nerdmaennchen/motor_unicorn_3000_hw/motor_unicorn.kicad_pcb

## KiCad design motor_unicorn.kicad_pcb (2024-05-05)

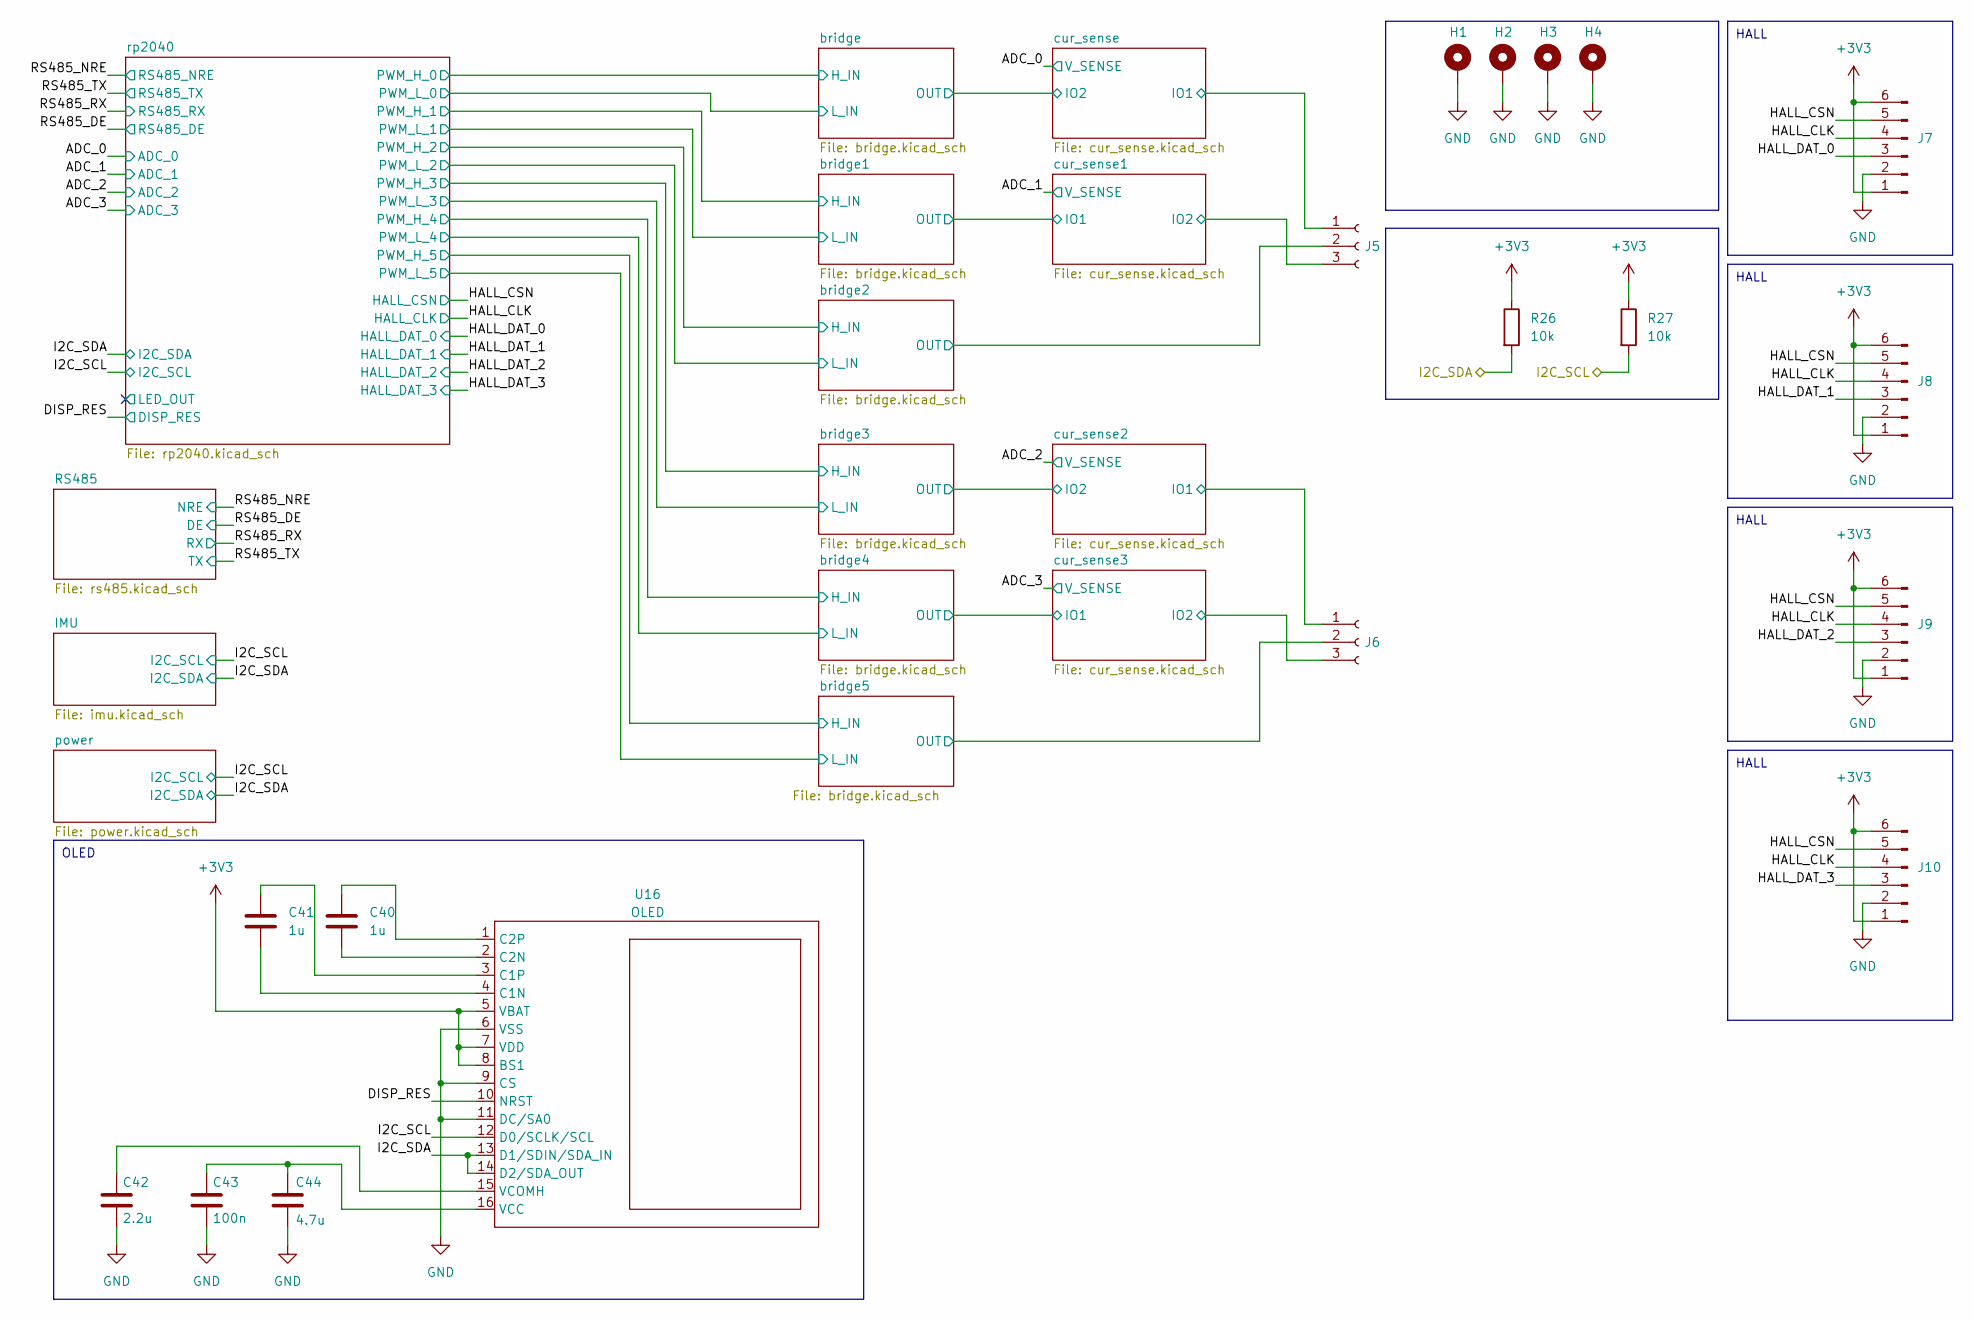
[picture p1: schematic motor_unicorn.kicad_sch]

Parts:
C40, C41: 1u; C_0402_1005Metric; LCSC C52923
C42: 2.2u; C_0805_2012Metric; LCSC C12530
C43: 100n; C_0402_1005Metric; LCSC C1525
C44: 4.7u; C_0603_1608Metric; LCSC C19666
H1, H2, H3, H4: MountingHole_Pad; MountingHole_3.2mm_M3_DIN965_Pad_TopBottom
J5, J6: Conn_01x03_Socket; TerminalBlock_Altech_AK300-3_P5.00mm; LCSC C8270
J7, J8, J9, J10: Conn_01x06_Pin; JST_PH_B6B-PH-K_1x06_P2.00mm_Vertical; LCSC C131342
R26, R27: 10k; R_0402_1005Metric
U16: OLED

Connections:
+3V3: J7.1, J7.6, J8.1, J8.6, J9.1, J9.6, J10.1, J10.6, R26.1, R27.1, U16.5 (VBAT), U16.7 (VDD), U16.8 (BS1); also elsewhere on the board
/DISP_RES: U16.10 (NRST); also elsewhere on the board
/HALL_CLK: J7.4, J8.4, J9.4, J10.4; also elsewhere on the board
/HALL_CSN: J7.5, J8.5, J9.5, J10.5; also elsewhere on the board
/HALL_DAT_0: J7.3; also elsewhere on the board
/HALL_DAT_1: J8.3; also elsewhere on the board
/HALL_DAT_2: J9.3; also elsewhere on the board
/HALL_DAT_3: J10.3; also elsewhere on the board
/I2C_SCL: R27.2, U16.12 (D0/SCLK/SCL); also elsewhere on the board
/I2C_SDA: R26.2, U16.13 (D1/SDIN/SDA_IN), U16.14 (D2/SDA_OUT); also elsewhere on the board
/bridge2/OUT: J5.2; also elsewhere on the board
/bridge5/OUT: J6.2; also elsewhere on the board
/cur_sense1/IO2: J5.3; also elsewhere on the board
/cur_sense2/IO1: J6.1; also elsewhere on the board
/cur_sense3/IO2: J6.3; also elsewhere on the board
/cur_sense/IO1: J5.1; also elsewhere on the board
GND: C42.2, C43.2, C44.2, H1.1, H2.1, H3.1, H4.1, J7.2, J8.2, J9.2, J10.2, U16.6 (VSS), U16.9 (CS), U16.11 (DC/SA0); also elsewhere on the board
unnamed: C41.2, U16.4 (C1N)
unnamed: C41.1, U16.3 (C1P)
unnamed: C40.2, U16.2 (C2N)
unnamed: C40.1, U16.1 (C2P)
unnamed: C43.1, C44.1, U16.16 (VCC)
unnamed: C42.1, U16.15 (VCOMH)

Notes on the sheet:
HALL
OLED

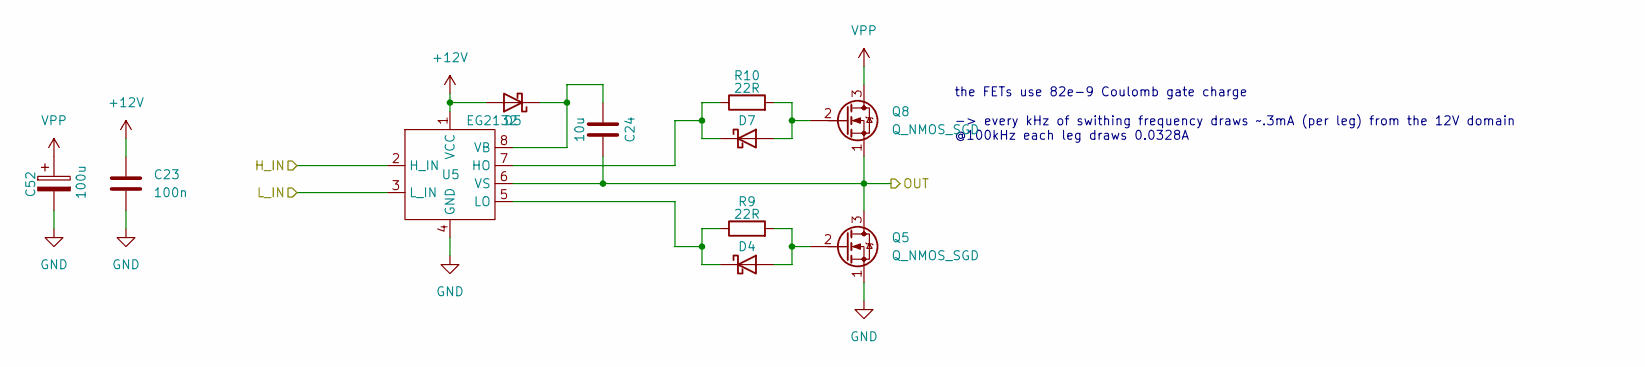
[picture p2: schematic bridge.kicad_sch]

Parts:
C23: 100n; C_0402_1005Metric
C24: 10u; C_0603_1608Metric
C52: 100u; CP_Elec_6.3x7.7
D4, D5, D7: D_Schottky; D_SOD-323
Q5, Q8: Q_NMOS_SGD; PQFN-8-EP_6x5mm_P1.27mm_Generic
R9, R10: 22R; R_0402_1005Metric
U5: EG2132; SSOP-8_3.9x5.05mm_P1.27mm

Connections:
+12V: C23.1, D5.2 (A), U5.1 (VCC); also elsewhere on the board
/bridge1/H_IN: U5.2 (H_IN); also elsewhere on the board
/bridge1/L_IN: U5.3 (L_IN); also elsewhere on the board
GND: C23.2, C52.2, Q5.1 (S), U5.4 (GND); also elsewhere on the board
unnamed: D7.1 (K), R10.1, U5.7 (HO)
VPP: C52.1, Q8.3 (D); also elsewhere on the board

Parts of its further copies:
C21, C26, C33, C35, C37: 10u; C_0603_1608Metric
C22, C25, C32, C34, C36: 100n; C_0402_1005Metric
C53, C54, C55, C56, C57: 100u; CP_Elec_6.3x7.7
D3, D6, D8, D9, D10, D11, D12, D13, D14, D15, D16, D17, D18, D19, D20: D_Schottky; D_SOD-323
Q2, Q3, Q4, Q6, Q7, Q9, Q10, Q11, Q12, Q13: Q_NMOS_SGD; PQFN-8-EP_6x5mm_P1.27mm_Generic
R8, R11, R12, R13, R18, R19, R20, R21, R22, R23: 22R; R_0402_1005Metric
U4, U6, U11, U12, U13: EG2132; SSOP-8_3.9x5.05mm_P1.27mm

Connections of its further copies:
+12V: C22.1, C25.1, C32.1, C34.1, C36.1, D6.2 (A), D9.2 (A), D12.2 (A), D15.2 (A), D18.2 (A), U4.1 (VCC), U6.1 (VCC), U11.1 (VCC), U12.1 (VCC), U13.1 (VCC); also elsewhere on the board
/bridge2/H_IN: U6.2 (H_IN); also elsewhere on the board
/bridge2/L_IN: U6.3 (L_IN); also elsewhere on the board
/bridge2/OUT: C26.1, Q4.3 (D), Q10.1 (S), U6.6 (VS); also elsewhere on the board
/bridge3/H_IN: U11.2 (H_IN); also elsewhere on the board
/bridge3/L_IN: U11.3 (L_IN); also elsewhere on the board
/bridge4/H_IN: U12.2 (H_IN); also elsewhere on the board
/bridge4/L_IN: U12.3 (L_IN); also elsewhere on the board
/bridge4/OUT: C35.1, Q6.3 (D), Q12.1 (S), U12.6 (VS); also elsewhere on the board
/bridge5/H_IN: U13.2 (H_IN); also elsewhere on the board
/bridge5/L_IN: U13.3 (L_IN); also elsewhere on the board
/bridge5/OUT: C37.1, Q7.3 (D), Q13.1 (S), U13.6 (VS); also elsewhere on the board
/bridge/H_IN: U4.2 (H_IN); also elsewhere on the board
/bridge/L_IN: U4.3 (L_IN); also elsewhere on the board
GND: C22.2, C25.2, C32.2, C34.2, C36.2, C53.2, C54.2, C55.2, C56.2, C57.2, Q2.1 (S), Q3.1 (S), Q4.1 (S), Q6.1 (S), Q7.1 (S), U4.4 (GND), U6.4 (GND), U11.4 (GND), U12.4 (GND), U13.4 (GND); also elsewhere on the board
unnamed: D3.1 (K), R8.1, U4.7 (HO)
unnamed: D8.2 (A), Q3.2 (G), R11.2
unnamed: C26.2, D9.1 (K), U6.8 (VB)
unnamed: D10.2 (A), Q10.2 (G), R12.2
unnamed: D10.1 (K), R12.1, U6.7 (HO)
unnamed: D11.2 (A), Q4.2 (G), R13.2
unnamed: D11.1 (K), R13.1, U6.5 (LO)
unnamed: C33.2, D12.1 (K), U11.8 (VB)
unnamed: D13.2 (A), Q11.2 (G), R18.2
unnamed: D13.1 (K), R18.1, U11.7 (HO)
unnamed: D14.1 (K), R19.1, U11.5 (LO)
unnamed: C35.2, D15.1 (K), U12.8 (VB)
unnamed: D16.2 (A), Q12.2 (G), R20.2
unnamed: D16.1 (K), R20.1, U12.7 (HO)
unnamed: D17.2 (A), Q6.2 (G), R21.2
unnamed: D17.1 (K), R21.1, U12.5 (LO)
unnamed: C37.2, D18.1 (K), U13.8 (VB)
unnamed: D19.2 (A), Q13.2 (G), R22.2
unnamed: D19.1 (K), R22.1, U13.7 (HO)
unnamed: D20.2 (A), Q7.2 (G), R23.2
unnamed: D20.1 (K), R23.1, U13.5 (LO)
VPP: C53.1, C54.1, C55.1, C56.1, C57.1, Q9.3 (D), Q10.3 (D), Q11.3 (D), Q12.3 (D), Q13.3 (D); also elsewhere on the board

Notes on the sheet:
the FETs use 82e-9 Coulomb gate charge -> every kHz of swithing frequency draws ~.3mA (per leg) from the 12V domain @100kHz each leg draws 0.0328A

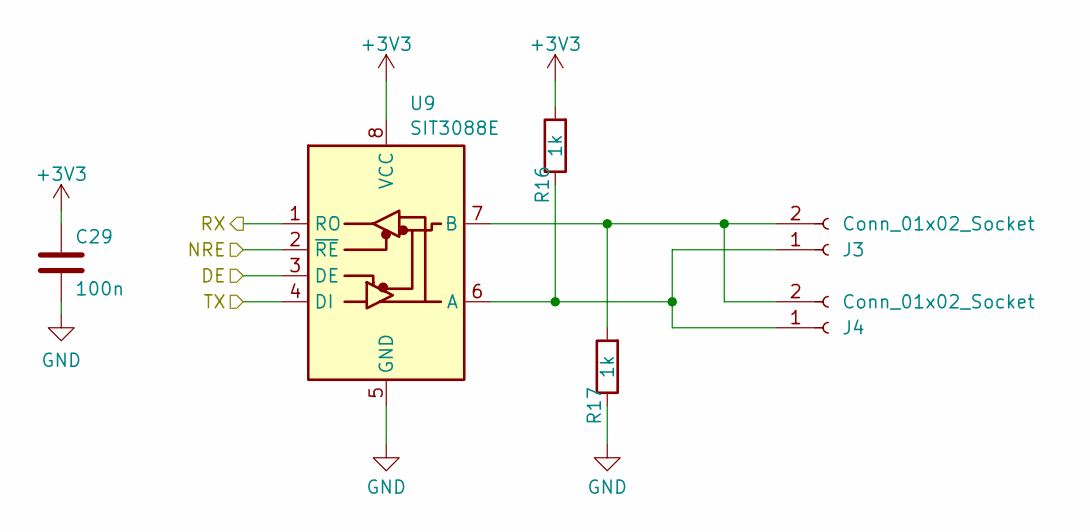
[picture p3: schematic rs485.kicad_sch]

Parts:
C29: 100n; C_0402_1005Metric
J3: Conn_01x02_Socket; Molex_PicoBlade_53398-0271_1x02-1MP_P1.25mm_Vertical; LCSC C395343
J4: Conn_01x02_Socket; Molex_PicoBlade_53398-0271_1x02-1MP_P1.25mm_Vertical
R16, R17: 1k; R_0402_1005Metric
U9: SIT3088E; DFN8-3x3mm

Connections:
+3V3: C29.1, R16.2, U9.8 (VCC); also elsewhere on the board
/RS485_DE: U9.3 (DE); also elsewhere on the board
/RS485_NRE: U9.2 (~RE); also elsewhere on the board
/RS485_RX: U9.1 (RO); also elsewhere on the board
/RS485_TX: U9.4 (DI); also elsewhere on the board
GND: C29.2, R17.1, U9.5 (GND); also elsewhere on the board
unnamed: J3.1, J4.1, R16.1, U9.6 (A)
unnamed: J3.2, J4.2, R17.2, U9.7 (B)

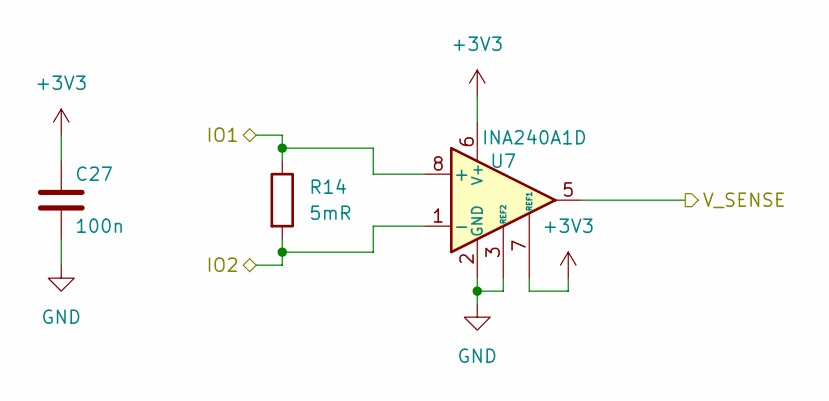
[picture p4: schematic cur_sense.kicad_sch]

Parts:
C27: 100n; C_0402_1005Metric
R14: 5mR; R_2512_6332Metric
U7: INA240A1D; SOIC-8_3.9x4.9mm_P1.27mm

Connections:
+3V3: C27.1, U7.6 (V+), U7.7 (REF1); also elsewhere on the board
/ADC_0: U7.5; also elsewhere on the board
/cur_sense/IO1: R14.1, U7.8 (+); also elsewhere on the board
GND: C27.2, U7.2 (GND), U7.3 (REF2), U7.4 (GND); also elsewhere on the board

Parts of its further copies:
C28, C38, C39: 100n; C_0402_1005Metric
R15, R24, R25: 5mR; R_2512_6332Metric
U8, U14, U15: INA240A1D; SOIC-8_3.9x4.9mm_P1.27mm

Connections of its further copies:
+3V3: C28.1, C38.1, C39.1, U8.6 (V+), U8.7 (REF1), U14.6 (V+), U14.7 (REF1), U15.6 (V+), U15.7 (REF1); also elsewhere on the board
/ADC_1: U8.5; also elsewhere on the board
/ADC_2: U14.5; also elsewhere on the board
/ADC_3: U15.5; also elsewhere on the board
/bridge4/OUT: R25.1, U15.8 (+); also elsewhere on the board
/cur_sense1/IO2: R15.2, U8.1 (-); also elsewhere on the board
/cur_sense2/IO1: R24.1, U14.8 (+); also elsewhere on the board
/cur_sense3/IO2: R25.2, U15.1 (-); also elsewhere on the board
GND: C28.2, C38.2, C39.2, U8.2 (GND), U8.3 (REF2), U8.4 (GND), U14.2 (GND), U14.3 (REF2), U14.4 (GND), U15.2 (GND), U15.3 (REF2), U15.4 (GND); also elsewhere on the board

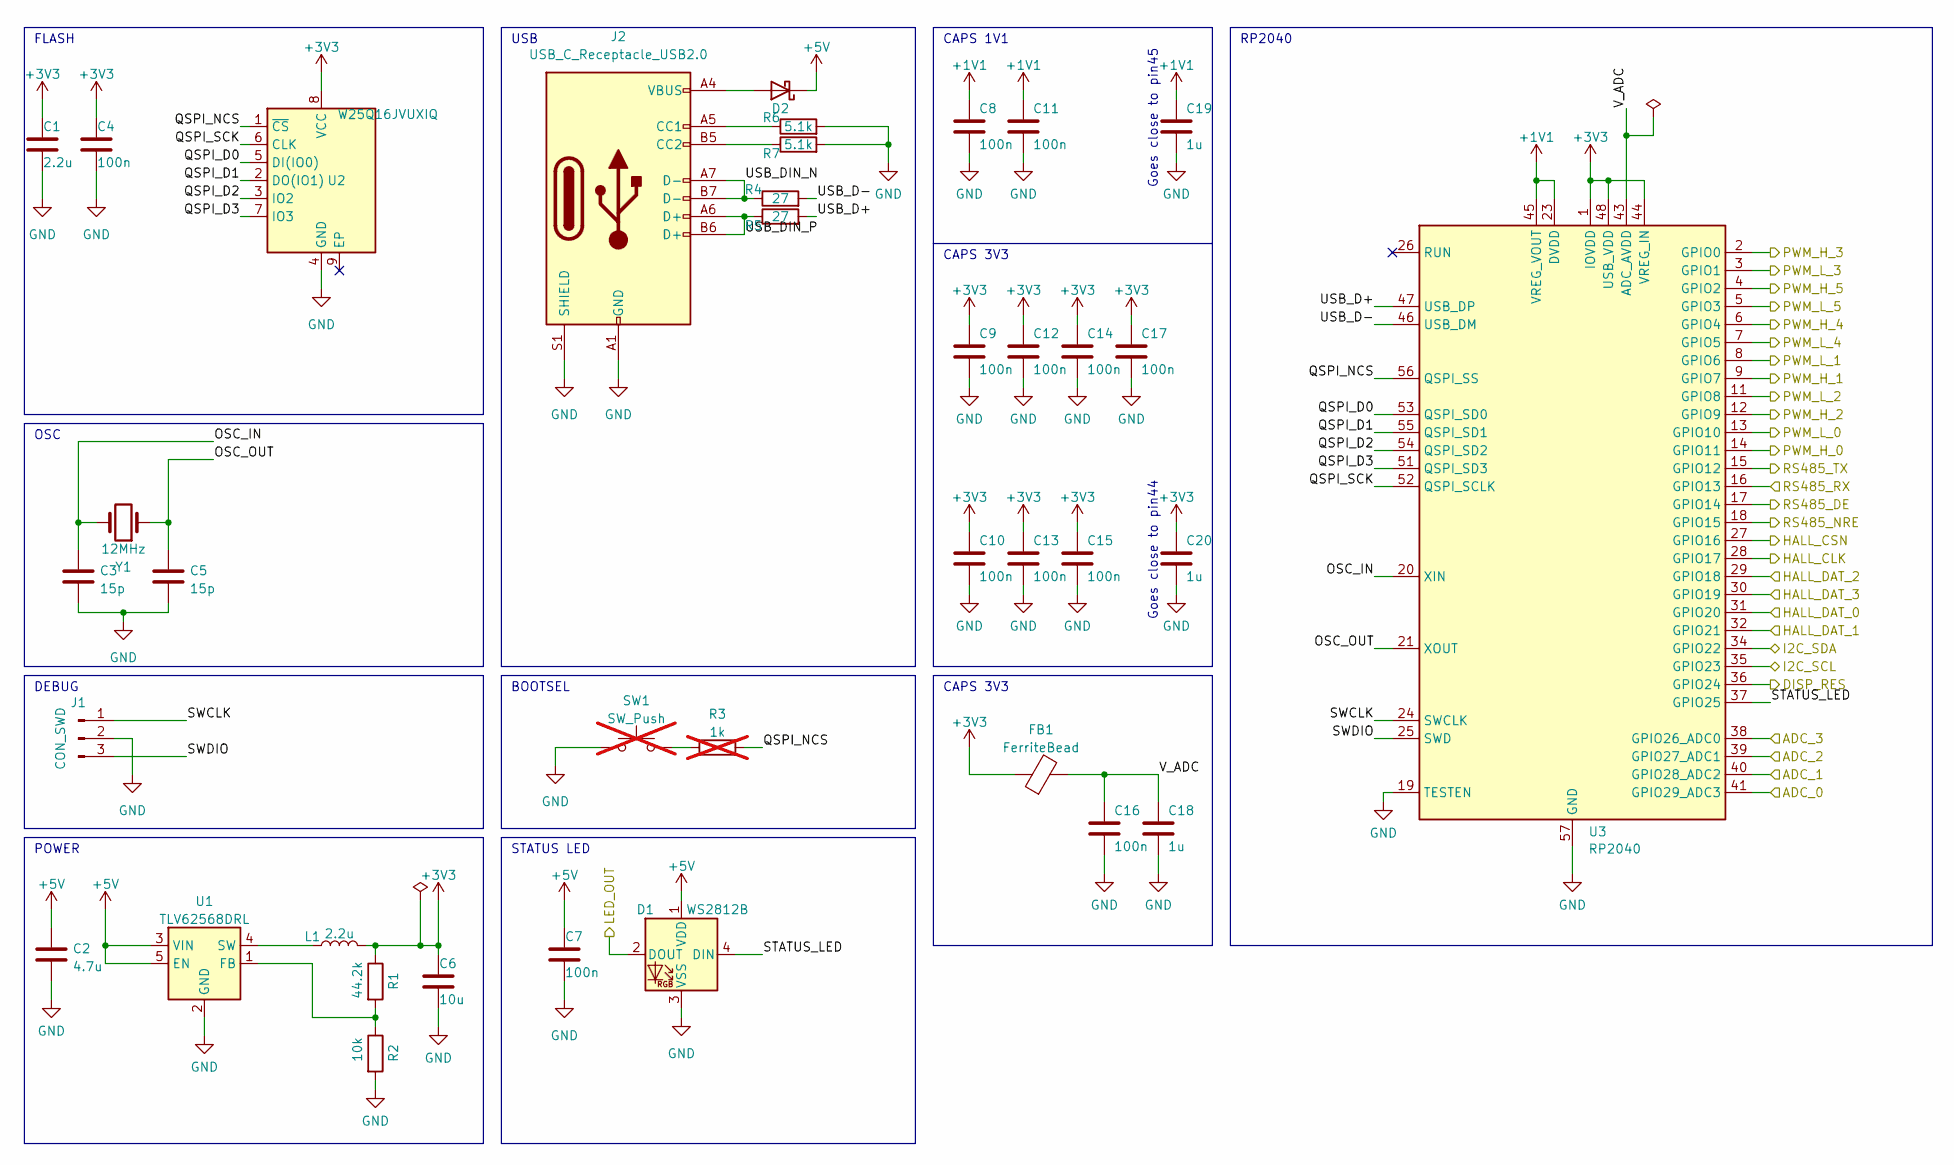
[picture p5: schematic rp2040.kicad_sch]

Parts:
C1: 2.2u; C_0402_1005Metric
C2: 4.7u; C_0603_1608Metric
C3, C5: 15p; C_0402_1005Metric
C4, C7, C8, C9, C10, C11, C12, C13, C14, C15, C16, C17: 100n; C_0402_1005Metric
C6: 10u; C_0603_1608Metric
C18, C19, C20: 1u; C_0402_1005Metric
D1: WS2812B; XL-1010RGBC-WS2812B
D2: D_Schottky; D_SOD-323
FB1: FerriteBead; L_0603_1608Metric
J1: CON_SWD; JST_SH_BM03B-SRSS-TB_1x03-1MP_P1.00mm_Vertical
J2: USB_C_Receptacle_USB2.0; USB_C_Receptacle_XKB_U262-16XN-4BVC11
L1: 2.2u; L_0603_1608Metric
R1: 44.2k; R_0402_1005Metric
R2: 10k; R_0402_1005Metric
R3: 1k; R_0402_1005Metric; not fitted
R4, R5: 27; R_0402_1005Metric
R6, R7: 5.1k; R_0402_1005Metric
SW1: SW_Push; SW_Push_1P1T_NO_Vertical_Wuerth_434133025816; not fitted
U1: TLV62568DRL; SOT-563
U2: W25Q16JVUXIQ; DFN-8-1EP_3x2mm_P0.5mm_EP1.3x1.5mm
U3: RP2040; QFN-56-1EP_7x7mm_P0.4mm_EP3.2x3.2mm
Y1: 12MHz; Crystal_SMD_3225-4Pin_3.2x2.5mm

Connections:
+1V1: C8.1, C11.1, C19.1, U3.23 (DVDD), U3.45 (VREG_VOUT), U3.50 (DVDD)
+3V3: C1.1, C4.1, C6.1, C9.1, C10.1, C12.1, C13.1, C14.1, C15.1, C17.1, C20.1, FB1.1, L1.2, R1.1, U2.8 (VCC), U3.1 (IOVDD), U3.10 (IOVDD), U3.22 (IOVDD), U3.33 (IOVDD), U3.42 (IOVDD), U3.44 (VREG_IN), U3.48 (USB_VDD), U3.49 (IOVDD); also elsewhere on the board
+5V: C2.1, C7.1, D1.1 (VDD), D2.1 (K), U1.3 (VIN), U1.5 (EN); also elsewhere on the board
/ADC_0: U3.41 (GPIO29_ADC3); also elsewhere on the board
/ADC_1: U3.40 (GPIO28_ADC2); also elsewhere on the board
/ADC_2: U3.39 (GPIO27_ADC1); also elsewhere on the board
/ADC_3: U3.38 (GPIO26_ADC0); also elsewhere on the board
/DISP_RES: U3.36 (GPIO24); also elsewhere on the board
/HALL_CLK: U3.28 (GPIO17); also elsewhere on the board
/HALL_CSN: U3.27 (GPIO16); also elsewhere on the board
/HALL_DAT_0: U3.31 (GPIO20); also elsewhere on the board
/HALL_DAT_1: U3.32 (GPIO21); also elsewhere on the board
/HALL_DAT_2: U3.29 (GPIO18); also elsewhere on the board
/HALL_DAT_3: U3.30 (GPIO19); also elsewhere on the board
/I2C_SCL: U3.35 (GPIO23); also elsewhere on the board
/I2C_SDA: U3.34 (GPIO22); also elsewhere on the board
/RS485_DE: U3.17 (GPIO14); also elsewhere on the board
/RS485_NRE: U3.18 (GPIO15); also elsewhere on the board
/RS485_RX: U3.16 (GPIO13); also elsewhere on the board
/RS485_TX: U3.15 (GPIO12); also elsewhere on the board
/bridge1/H_IN: U3.9 (GPIO7); also elsewhere on the board
/bridge1/L_IN: U3.8 (GPIO6); also elsewhere on the board
/bridge2/H_IN: U3.12 (GPIO9); also elsewhere on the board
/bridge2/L_IN: U3.11 (GPIO8); also elsewhere on the board
/bridge3/H_IN: U3.2 (GPIO0); also elsewhere on the board
/bridge3/L_IN: U3.3 (GPIO1); also elsewhere on the board
/bridge4/H_IN: U3.6 (GPIO4); also elsewhere on the board
/bridge4/L_IN: U3.7 (GPIO5); also elsewhere on the board
/bridge5/H_IN: U3.4 (GPIO2); also elsewhere on the board
/bridge5/L_IN: U3.5 (GPIO3); also elsewhere on the board
/bridge/H_IN: U3.14 (GPIO11); also elsewhere on the board
/bridge/L_IN: U3.13 (GPIO10); also elsewhere on the board
/rp2040/LED_OUT: D1.2 (DOUT)
/rp2040/OSC_IN: C3.1, U3.20 (XIN), Y1.3 (2)
/rp2040/OSC_OUT: C5.1, U3.21 (XOUT), Y1.1
/rp2040/QSPI_D0: U2.5 (DI(IO0)), U3.53 (QSPI_SD0)
/rp2040/QSPI_D1: U2.2 (DO(IO1)), U3.55 (QSPI_SD1)
/rp2040/QSPI_D2: U2.3 (IO2), U3.54 (QSPI_SD2)
/rp2040/QSPI_D3: U2.7 (IO3), U3.51 (QSPI_SD3)
/rp2040/QSPI_NCS: R3.2, U2.1 (~CS), U3.56 (QSPI_SS)
/rp2040/QSPI_SCK: U2.6 (CLK), U3.52 (QSPI_SCLK)
/rp2040/STATUS_LED: D1.4 (DIN), U3.37 (GPIO25)
/rp2040/SWCLK: J1.1, U3.24 (SWCLK)
/rp2040/SWDIO: J1.3, U3.25 (SWD)
/rp2040/USB_D+: R5.2, U3.47 (USB_DP)
/rp2040/USB_D-: R4.2, U3.46 (USB_DM)
/rp2040/USB_DIN_N: J2.A7 (D-), J2.B7 (D-), R4.1
/rp2040/USB_DIN_P: J2.A6 (D+), J2.B6 (D+), R5.1
/rp2040/V_ADC: C16.1, C18.1, FB1.2, U3.43 (ADC_AVDD)
GND: C1.2, C2.2, C3.2, C4.2, C5.2, C6.2, C7.2, C8.2, C9.2, C10.2, C11.2, C12.2, C13.2, C14.2, C15.2, C16.2, C17.2, C18.2, C19.2, C20.2, D1.3 (VSS), J1.2, J2.A1 (GND), J2.A12 (GND), J2.B1 (GND), J2.B12 (GND), J2.S1 (SHIELD), R2.2, R6.2, R7.2, SW1.1, U1.2 (GND), U2.4 (GND), U3.19 (TESTEN), U3.57 (GND); also elsewhere on the board
unnamed: D2.2 (A), J2.A4 (VBUS), J2.A9 (VBUS), J2.B4 (VBUS), J2.B9 (VBUS)
unnamed: J2.A5 (CC1), R6.1
unnamed: J2.B5 (CC2), R7.1
unnamed: R3.1, SW1.2
unnamed: R1.2, R2.1, U1.1 (FB)
unnamed: L1.1, U1.4 (SW)

Notes on the sheet:
OSC
DEBUG
Goes close to pin45
CAPS 3V3
STATUS LED
BOOTSEL
CAPS 1V1
Goes close to pin44
POWER
RP2040
USB
FLASH

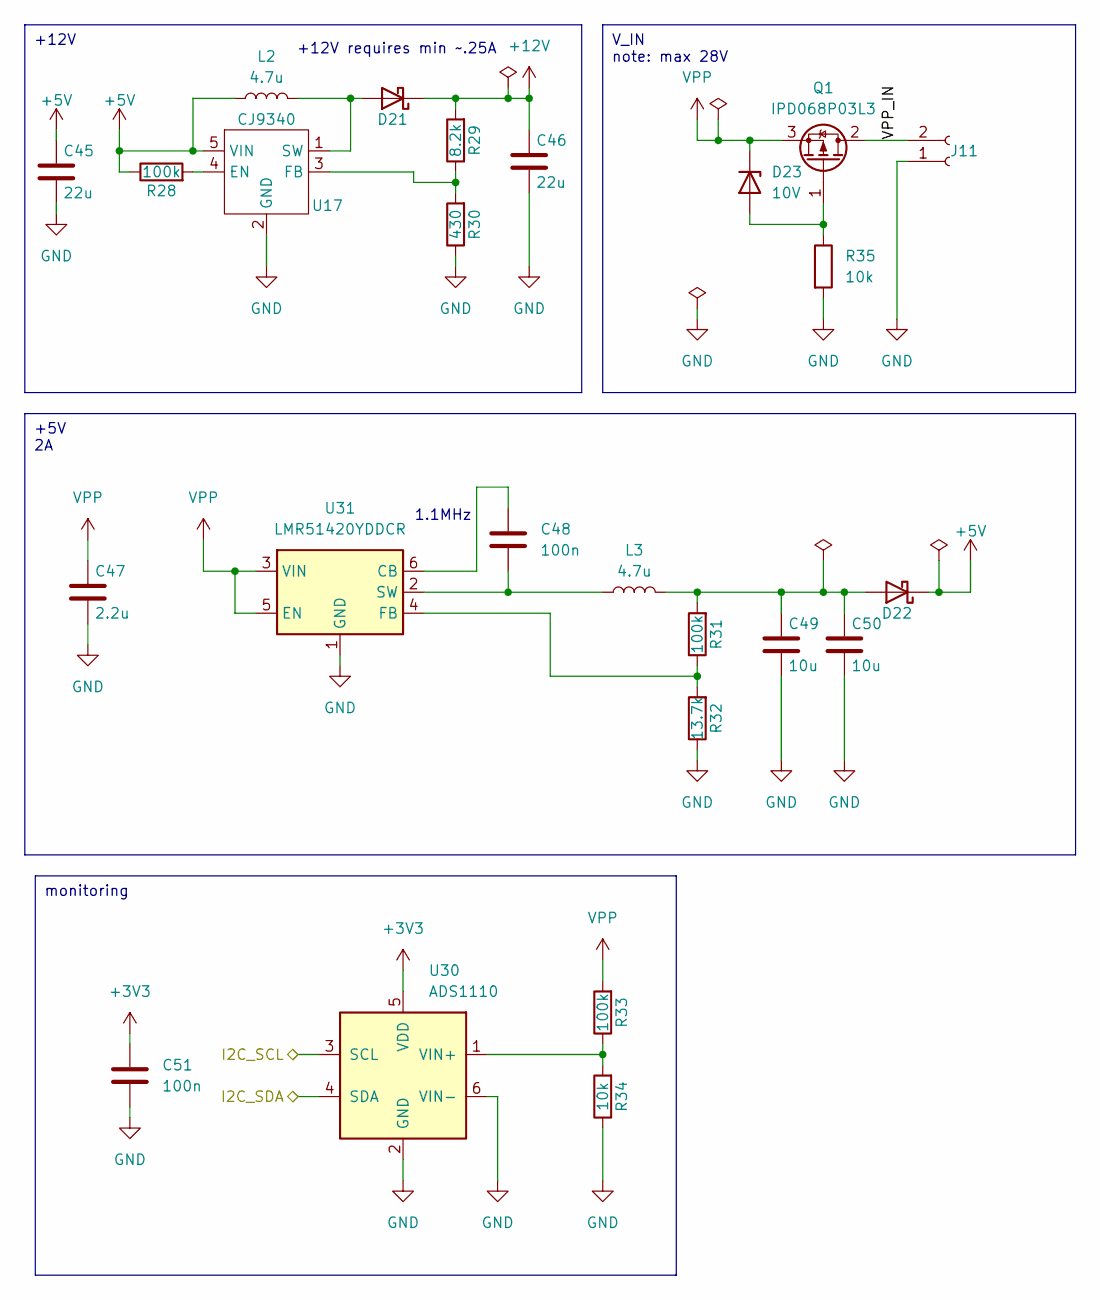
[picture p6: schematic power.kicad_sch]

Parts:
C45: 22u; C_0805_2012Metric; LCSC C45783
C46: 22u; C_0805_2012Metric
C47: 2.2u; C_0805_2012Metric
C48, C51: 100n; C_0402_1005Metric
C49, C50: 10u; C_0603_1608Metric
D21, D22: D_Schottky; D_SOD-323
D23: 10V; D_SOD-323
J11: Conn_01x02_Socket; TerminalBlock_bornier-2_P5.08mm
L2, L3: 4.7u; L_0603_1608Metric
Q1: IPD068P03L3; TO-252-2
R28, R31, R33: 100k; R_0402_1005Metric
R29: 8.2k; R_0402_1005Metric
R30: 430; R_0402_1005Metric
R32: 13.7k; R_0402_1005Metric
R34, R35: 10k; R_0402_1005Metric
U17: CJ9340; SOT-23-6
U30: ADS1110; SOT-23-6
U31: LMR51420YDDCR; SOT-23-6

Connections:
+3V3: C51.1, U30.5 (VDD); also elsewhere on the board
+5V: C45.1, D22.1 (K), L2.1, R28.1, U17.5 (VIN); also elsewhere on the board
+12V: C46.1, D21.1 (K), R29.2; also elsewhere on the board
/I2C_SCL: U30.3 (SCL); also elsewhere on the board
/I2C_SDA: U30.4 (SDA); also elsewhere on the board
/power/VPP_IN: J11.2, Q1.2 (D)
GND: C45.2, C46.2, C47.2, C49.2, C50.2, C51.2, J11.1, R30.1, R32.1, R34.1, R35.2, U17.2 (GND), U30.2 (GND), U30.6 (VIN-), U31.1 (GND); also elsewhere on the board
unnamed: D21.2 (A), L2.2, U17.1 (SW)
unnamed: C49.1, C50.1, D22.2 (A), L3.2, R31.2
unnamed: D23.2 (A), Q1.1 (G), R35.1
unnamed: R28.2, U17.4 (EN)
unnamed: R29.1, R30.2, U17.3 (FB)
unnamed: R33.1, R34.2, U30.1 (VIN+)
unnamed: C48.1, U31.6 (CB)
unnamed: R31.1, R32.2, U31.4 (FB)
unnamed: C48.2, L3.1, U31.2 (SW)
VPP: C47.1, D23.1 (K), Q1.3 (S), R33.2, U31.3 (VIN), U31.5 (EN); also elsewhere on the board

Notes on the sheet:
monitoring
V_IN note: max 28V
+5V 2A
+12V
1.1MHz
+12V requires min ~.25A

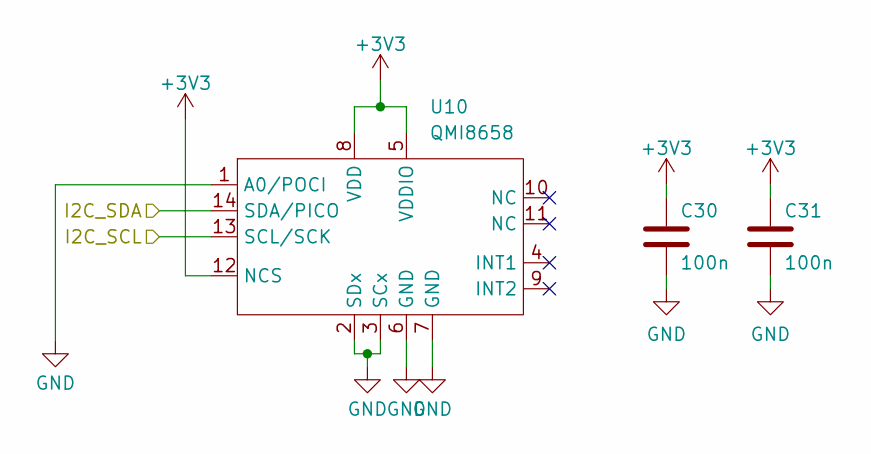
[picture p7: schematic imu.kicad_sch]

Parts:
C30, C31: 100n; C_0402_1005Metric
U10: QMI8658; Bosch_LGA-14_3x2.5mm_P0.5mm

Connections:
+3V3: C30.1, C31.1, U10.5 (VDDIO), U10.8 (VDD), U10.12 (NCS); also elsewhere on the board
/I2C_SCL: U10.13 (SCL/SCK); also elsewhere on the board
/I2C_SDA: U10.14 (SDA/PICO); also elsewhere on the board
GND: C30.2, C31.2, U10.1 (A0/POCI), U10.2 (SDx), U10.3 (SCx), U10.6 (GND), U10.7 (GND); also elsewhere on the board

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
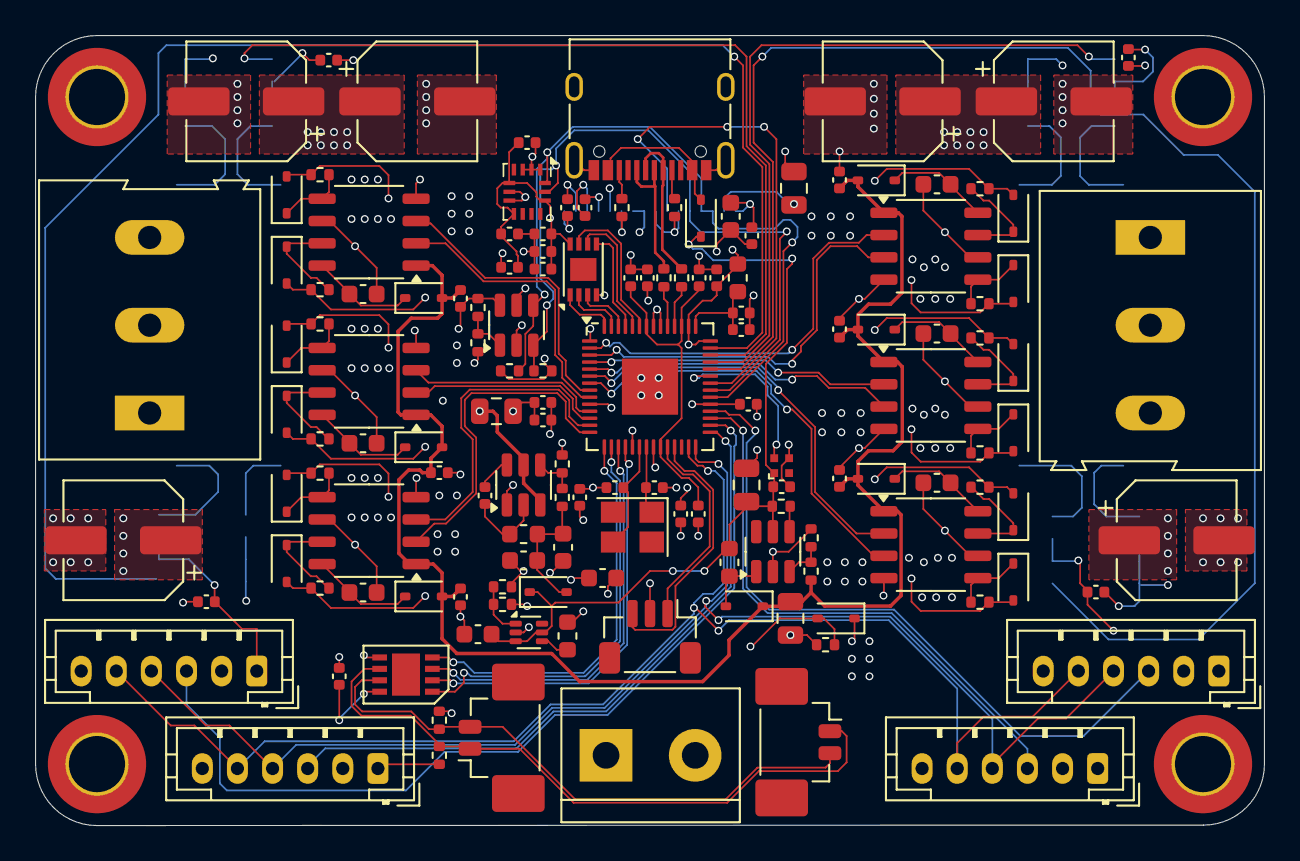
[picture p8: board motor_unicorn.kicad_pcb from above]

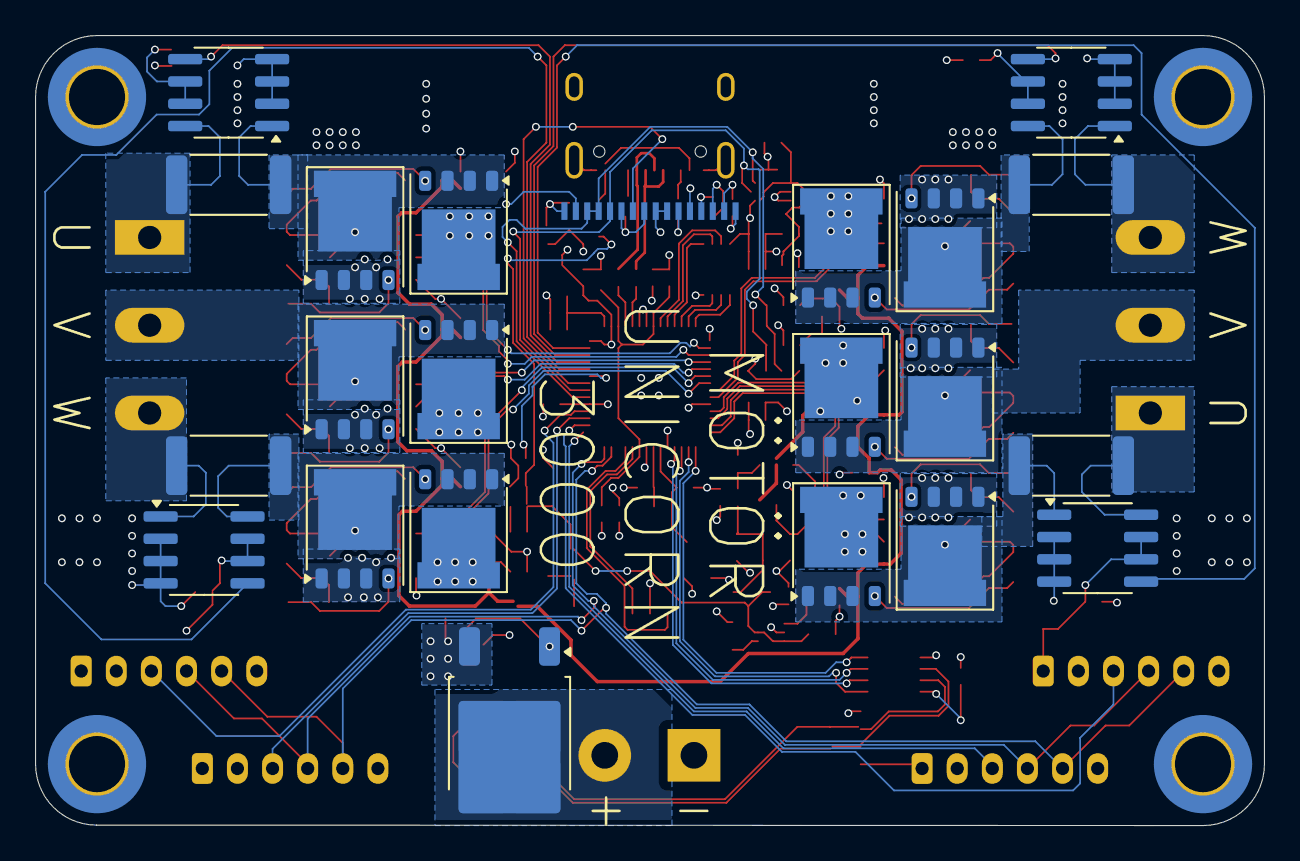
[picture p9: board motor_unicorn.kicad_pcb from below]

Board: 4 copper layers, 70.0 x 45.0 mm, 166 parts (22 on the bottom side), 114 nets.
