nerdmaennchen/motor_unicorn_3000_hw/(commit log)

2024-04-02 cleanups and last i2c connections
    [motor_unicorn.kicad_sch]
2024-04-02 more connections
    [motor_unicorn.kicad_sch, power.kicad_sch, rp2040.kicad_sch]
2024-05-04 finalized the design
    [bridge.kicad_sch, cur_sense.kicad_sch, imu.kicad_sch, motor_unicorn.kicad_pcb, power.kicad_sch, rp2040.kicad_sch, rs485.kicad_sch]
2024-05-05 ordered version
    [bridge.kicad_sch, cur_sense.kicad_sch, imu.kicad_sch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]
2024-05-05 tiny last minute fixes
    [motor_unicorn-CuBottom.gbr, motor_unicorn-CuIn1.gbr, motor_unicorn-CuIn2.gbr, motor_unicorn-CuTop.gbr, motor_unicorn-EdgeCuts.gbr, motor_unicorn-MaskBottom.gbr, motor_unicorn-MaskTop.gbr, motor_unicorn-NPTH.drl]
